marsgx9900/0914/Picture/backward.jpg

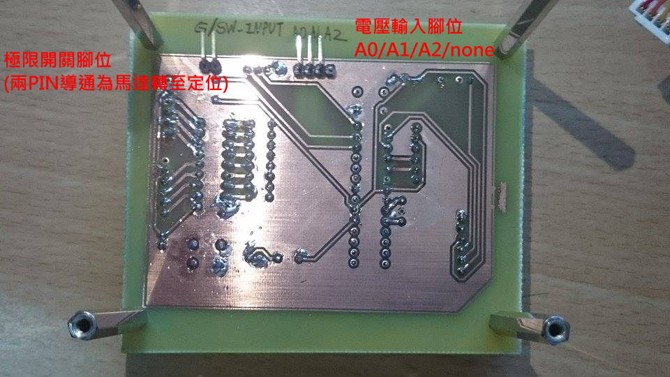
Picture/backward.jpg
