marsgx9900/0914/Picture/forward.jpg

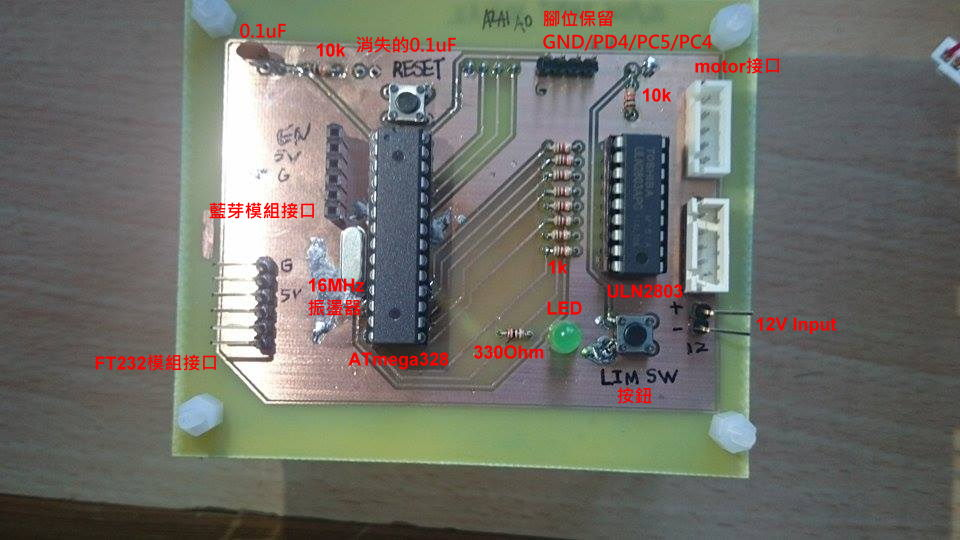
Picture/forward.jpg
