marsgx9900/0914/Layout/5Vto3V3_VoltageConverter/psu_sch.png

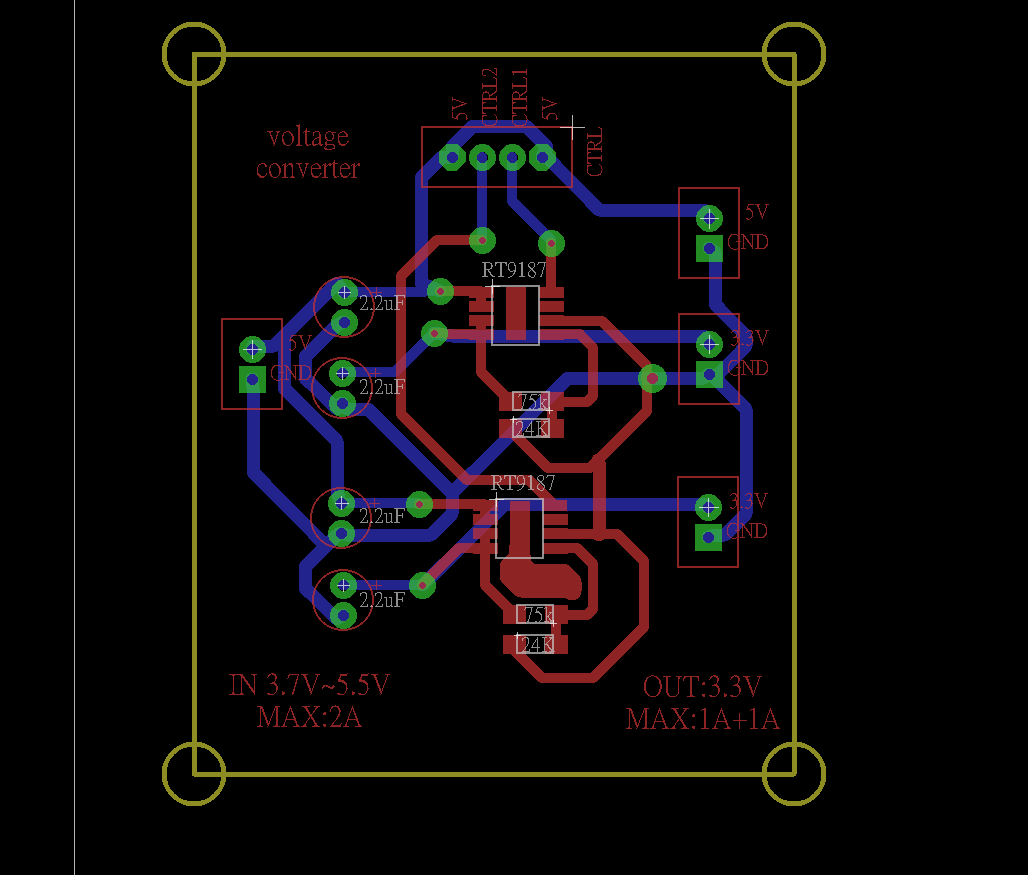
Layout/5Vto3V3_VoltageConverter/psu_sch.png
