marsgx9900/0914/Layout/LNA控制電路/schPic.png

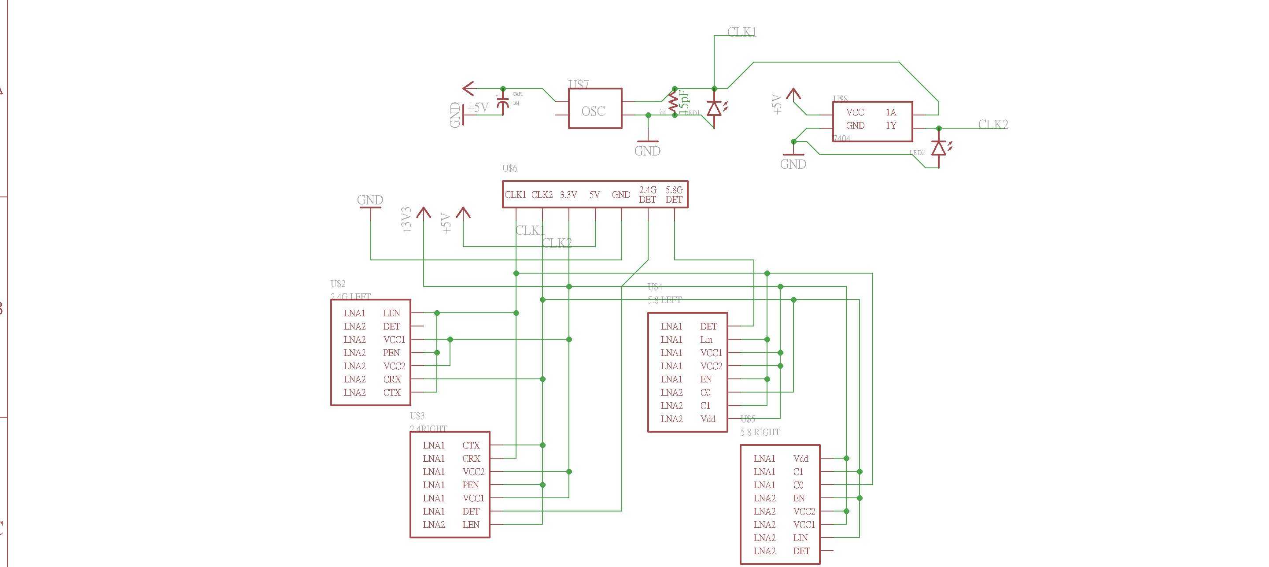
Layout/LNA控制電路/schPic.png
