marsgx9900/0914/Layout/main/brdPic.png

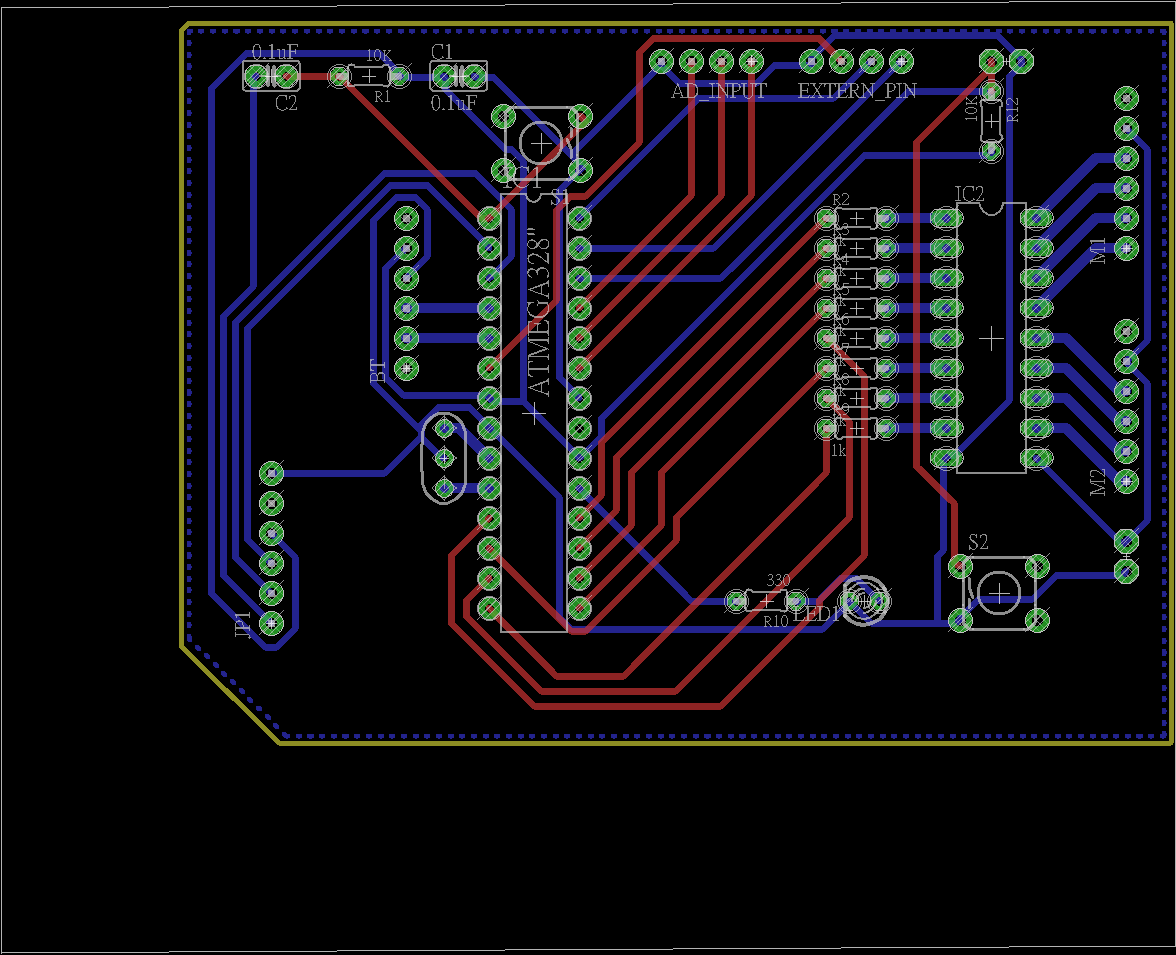
Layout/main/brdPic.png
