marsgx9900/0914/Layout/main/schPic.png

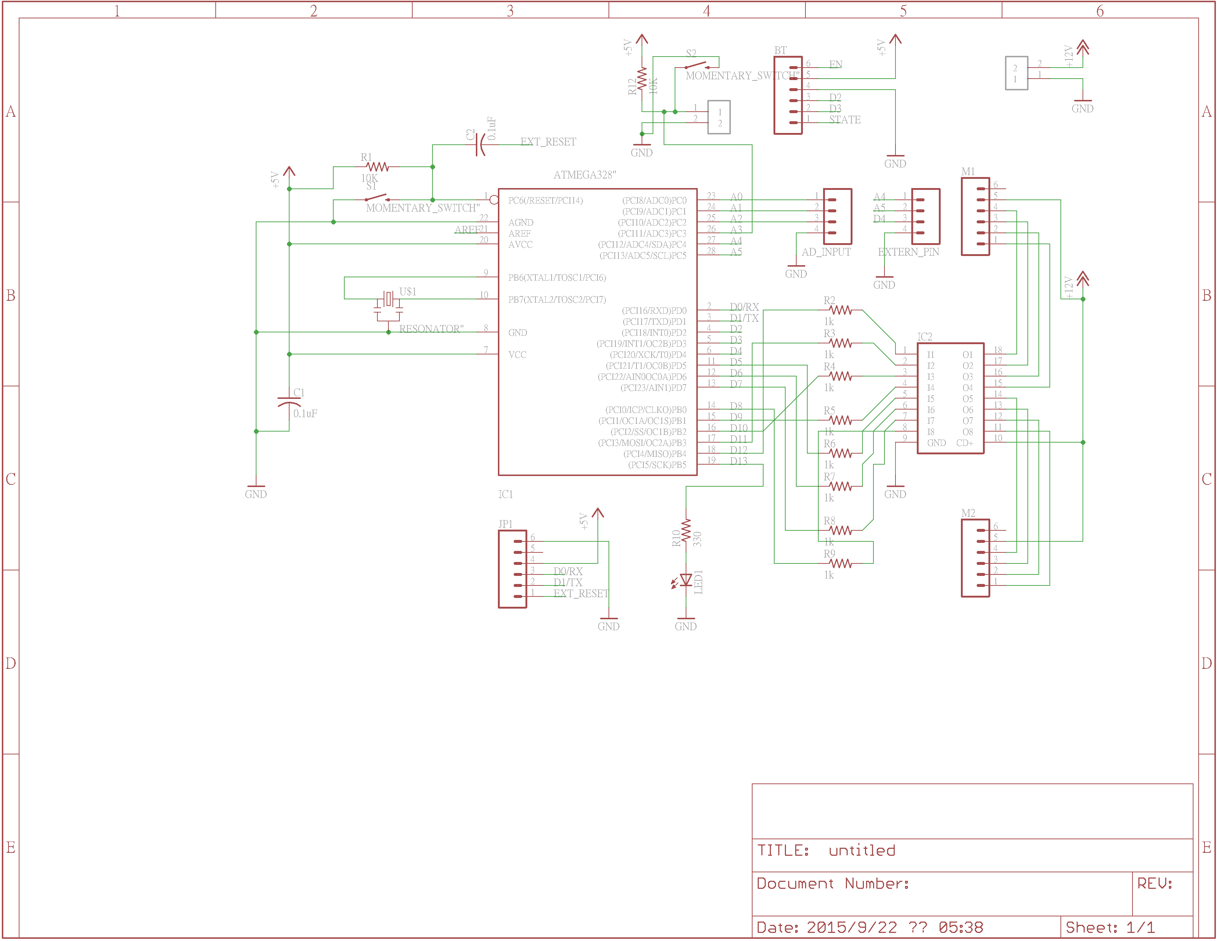
Layout/main/schPic.png
