marsgx9900/0914/Layout/LNA匹配電路/匹配電路.pdf

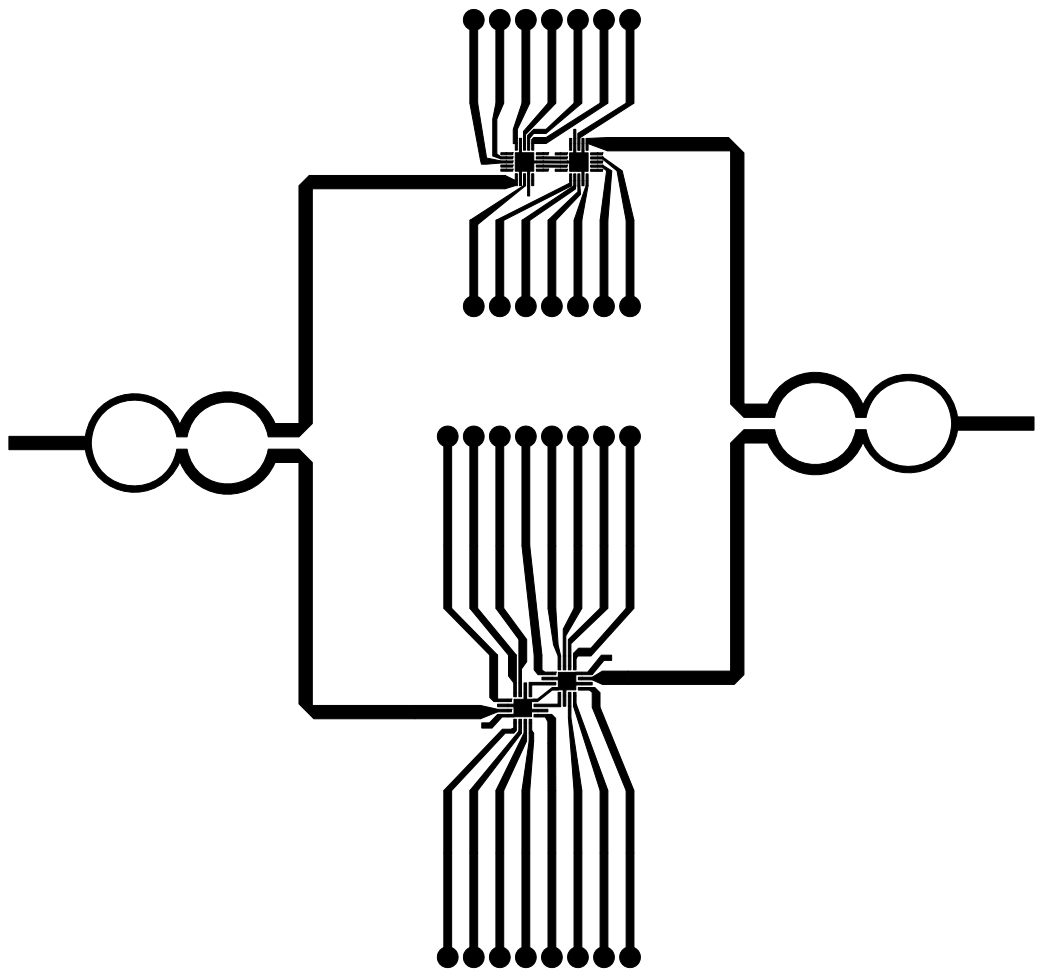
[picture p39: page 1]
