marsgx9900/0914/Layout/LNA控制電路/top.pdf

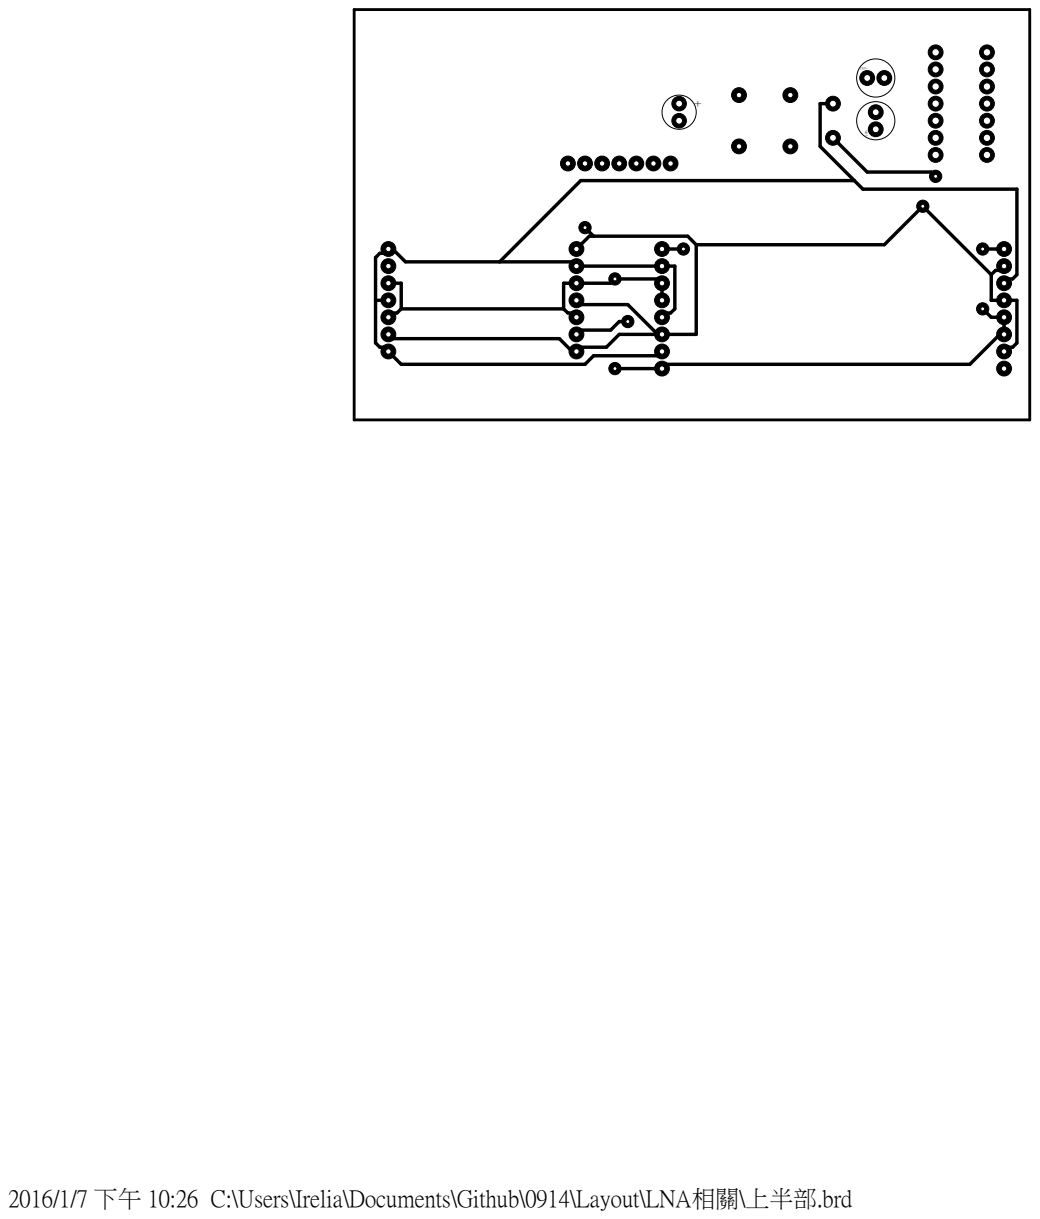
[picture p40: page 1]

2016/1/7 下午 10:26 C:\Users\Irelia\Documents\Github\0914\Layout\LNA相關\上半部.brd
