marsgx9900/0914/Layout/LNA控制電路/控制電路_bot.pdf

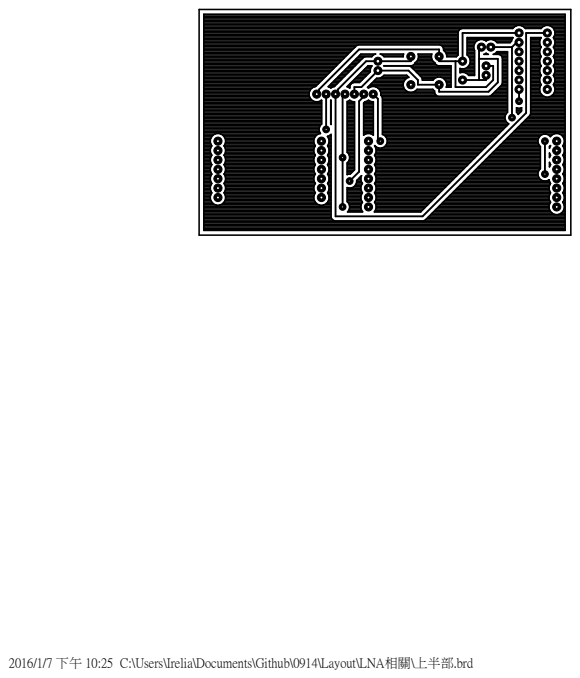
[picture p41: page 1]

2016/1/7 下午 10:25 C:\Users\Irelia\Documents\Github\0914\Layout\LNA相關\上半部.brd
