marsgx9900/0914/Layout/5Vto3V3_VoltageConverter/bottom.pdf

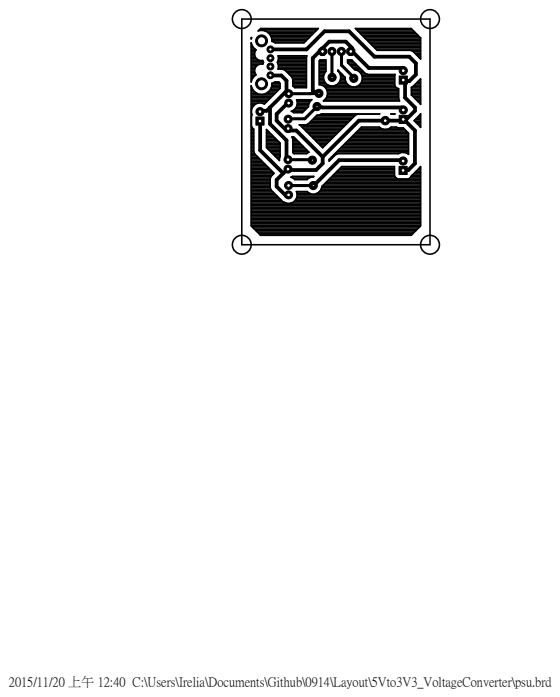
[picture p42: page 1]

2015/11/20 上午 12:40 C:\Users\Irelia\Documents\Github\0914\Layout\5Vto3V3_VoltageConverter\psu.brd
