marsgx9900/0914/Layout/5Vto3V3_VoltageConverter/top.pdf

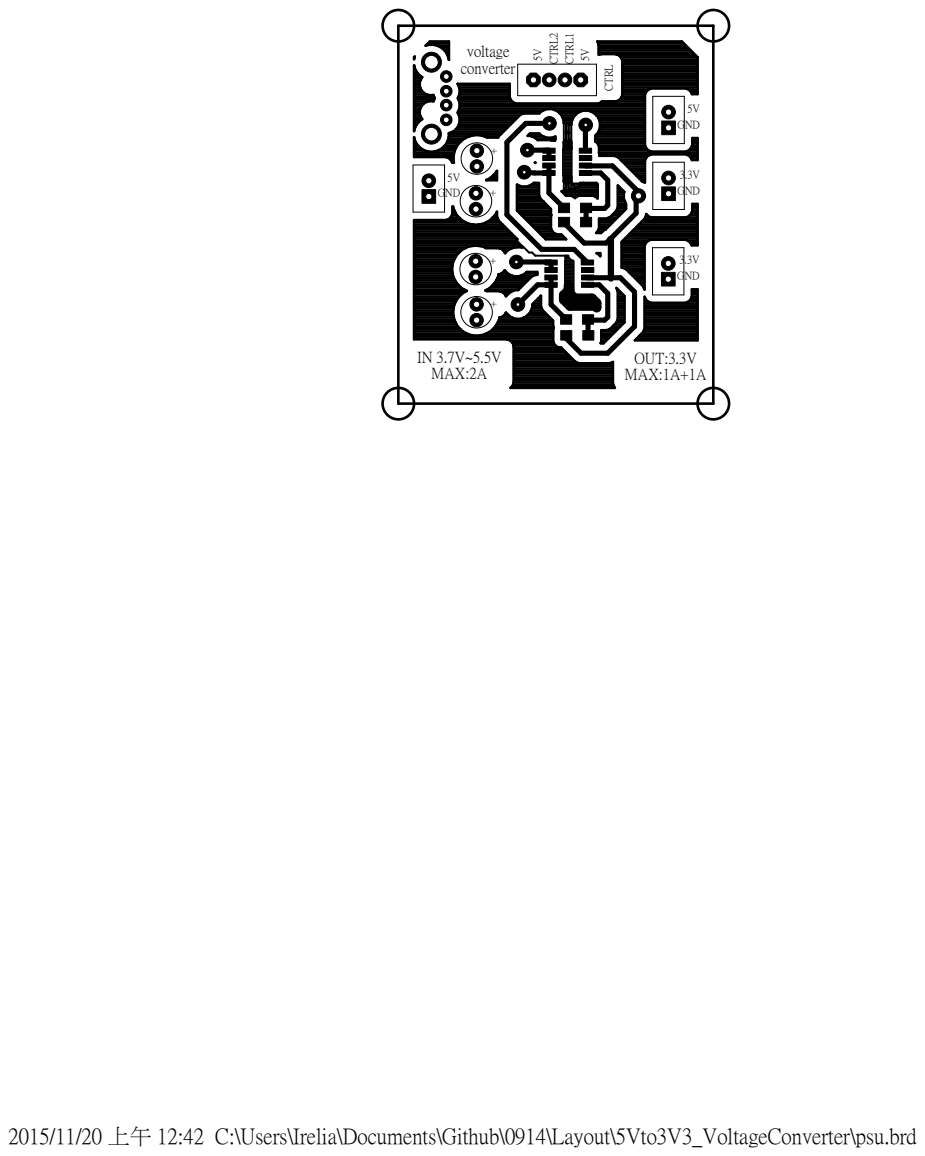
[picture p43: page 1]

2015/11/20 上午 12:42 C:\Users\Irelia\Documents\Github\0914\Layout\5Vto3V3_VoltageConverter\psu.brd
