marsgx9900/0914/Layout/main/bottom.pdf

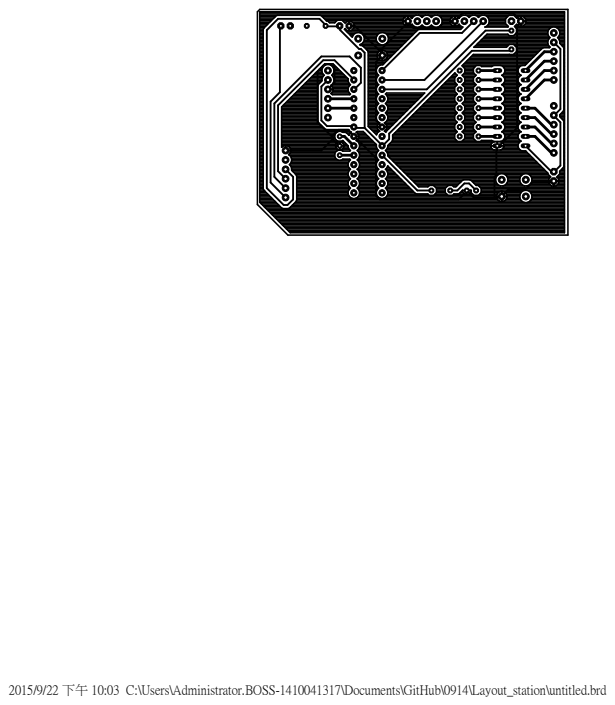
[picture p44: page 1]

2015/9/22 下午 10:03 C:\Users\Administrator.BOSS-1410041317\Documents\GitHub\0914\Layout_station\untitled.brd
