marsgx9900/0914/Layout/main/top.pdf

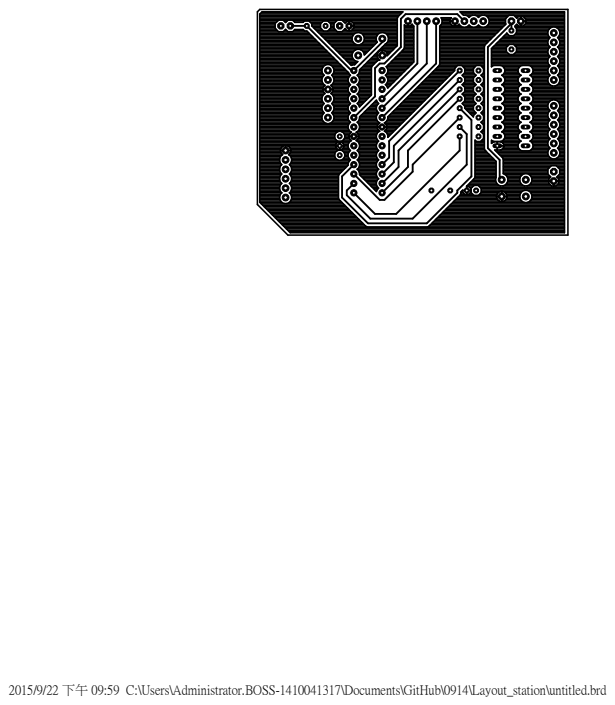
[picture p45: page 1]

2015/9/22 下午 09:59 C:\Users\Administrator.BOSS-1410041317\Documents\GitHub\0914\Layout_station\untitled.brd
