marsgx9900/0914/Layout/LNA控制電路/控制電路.brd

## EAGLE design Layout/LNA控制電路/控制電路.brd (2016-01-09)

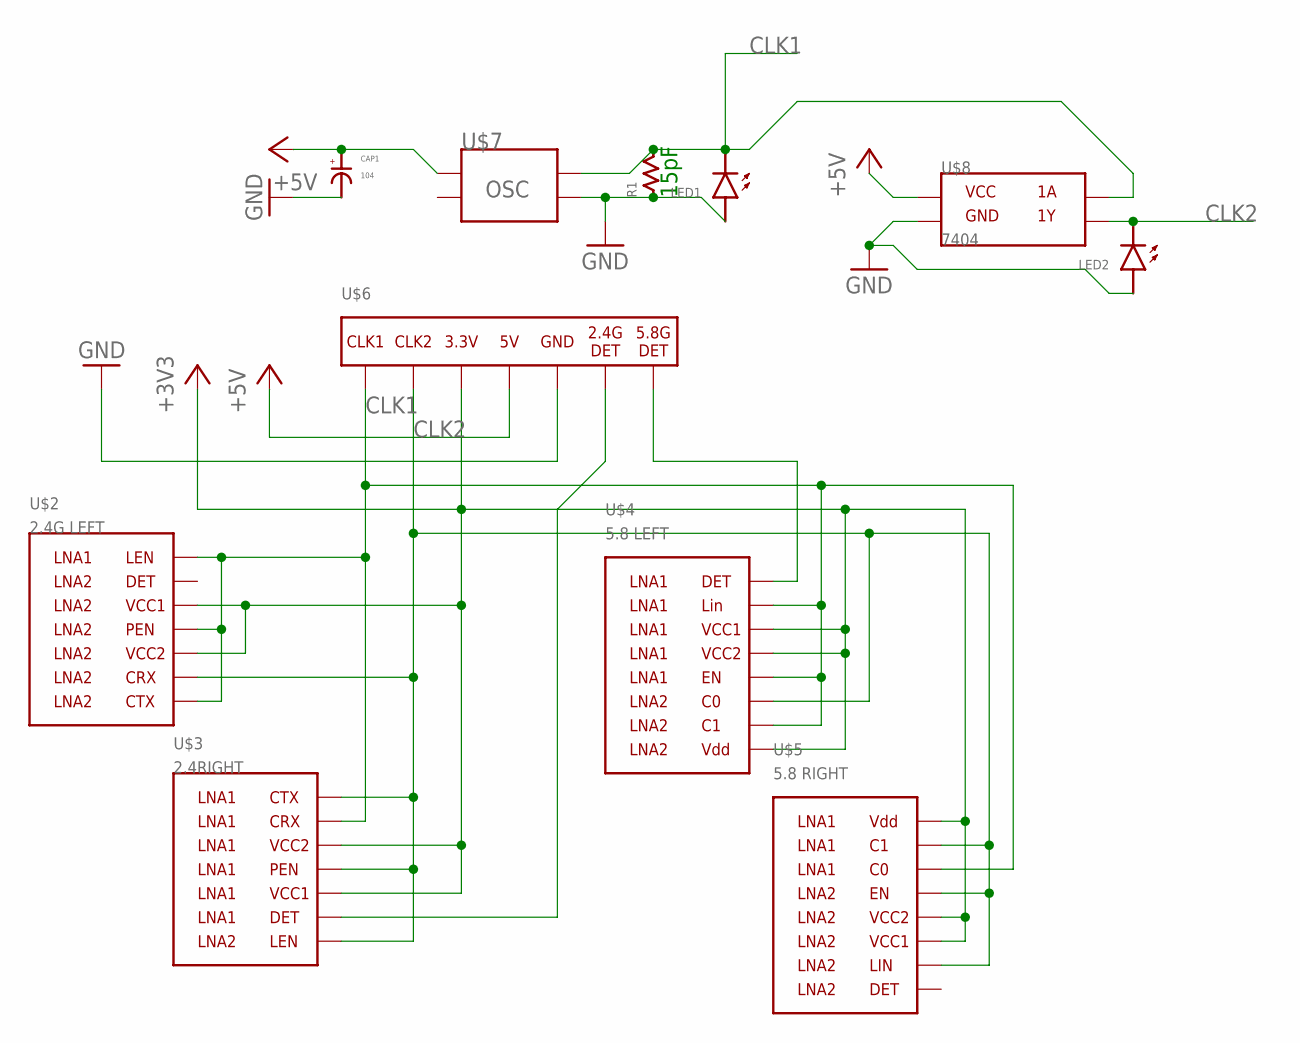
[picture p46: schematic 控制電路.sch]

Parts:
CAP1: 104; CAP-100MIL
LED1, LED2: LED-5MM; 2-PIN-200MIL-LED
R1: RESISTOR-200MIL
U$2: PROJECT-2.4G-LEFTSIDE
U$3: PROJECT-2.4G-RIGHTSIDE
U$4: PROJECT-5G-LEFTSIDE
U$5: PROJECT-5G-RIGHTSIDE
U$6: PROJECT-IO
U$7: PROJECT-CRYSTAL
U$8: PROJECT-7404

Connections:
+3V3: U$2.VCC1, U$2.VCC2, U$3.VCC1, U$3.VCC2, U$4.VCC1, U$4.VCC2, U$4.VDD, U$5.VCC1, U$5.VCC2, U$5.VDD, U$6.3.3V
+5V: CAP1.P$1, U$6.5V, U$7.P$1, U$8.P$14
CLK1: LED1.L- (LED-), R1.P$2, U$2.CTX, U$2.LEN, U$2.PEN, U$3.CRX, U$4.C1, U$4.EN, U$4.LIN, U$5.C0, U$6.CLK1, U$7.P$4, U$8.P$1
CLK2: LED2.L- (LED-), U$2.CRX, U$3.CTX, U$3.LEN, U$3.PEN, U$4.C0, U$5.C1, U$5.EN, U$5.LIN, U$6.CLK2, U$8.P$2
GND: CAP1.P$2, LED1.L+ (LED+), LED2.L+ (LED+), R1.P$1, U$6.GND, U$7.P$3, U$8.P$7
unnamed: U$3.DET, U$6.2.4DET
unnamed: U$4.DET, U$6.5.8DET

Notes on the sheet:
15pF

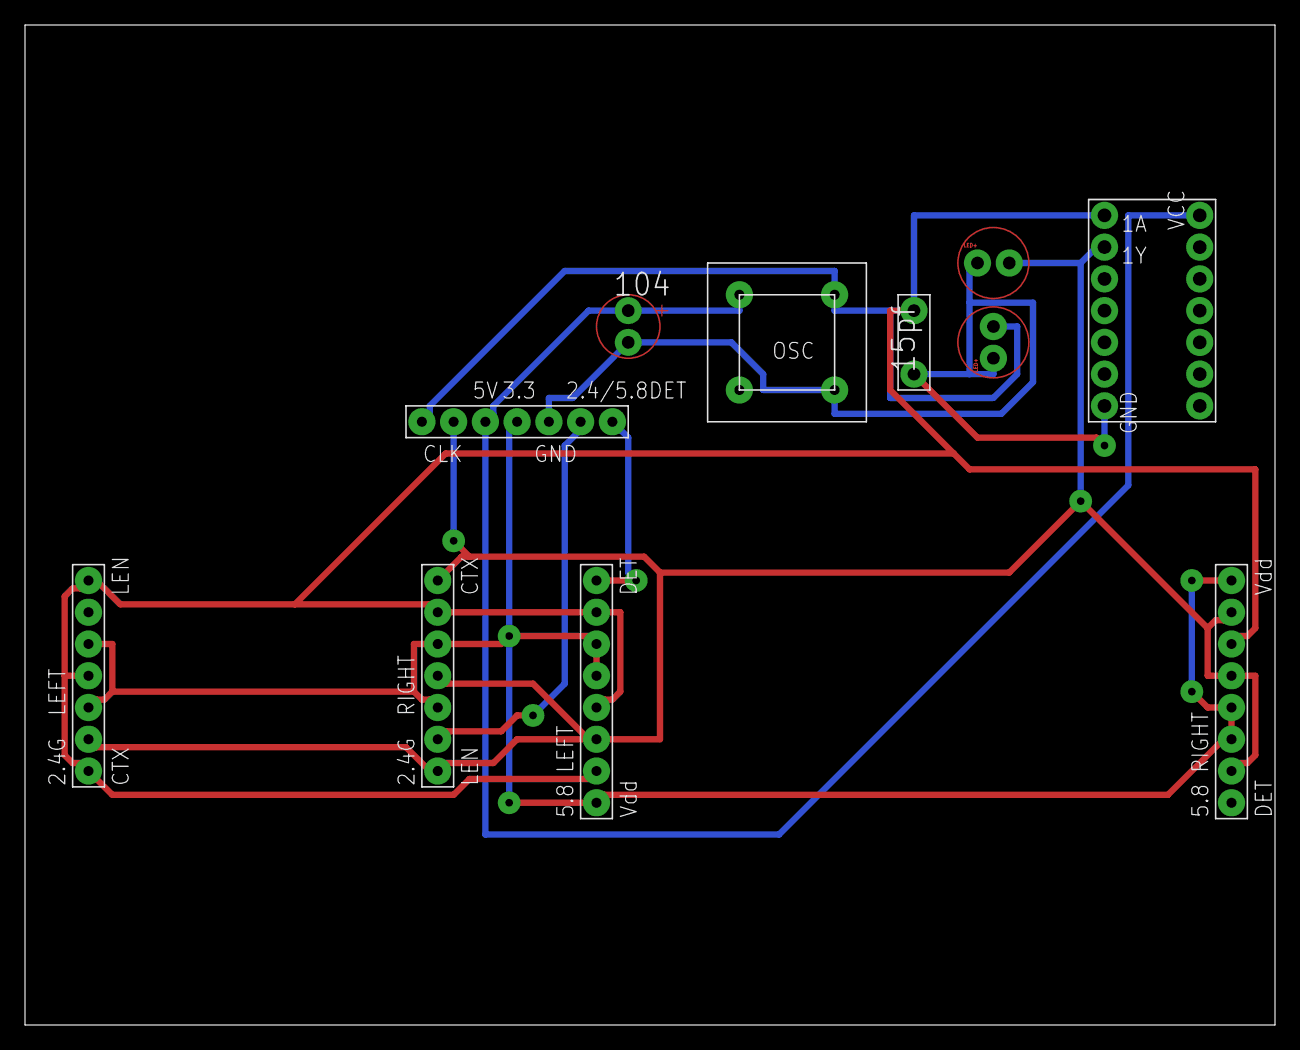
[picture p47: board 控制電路.brd from above]

Board: 2 copper layers, 100.0 x 80.0 mm, 11 parts (0 on the bottom side), 7 nets.
