marsgx9900/0914/Layout/5Vto3V3_VoltageConverter/psu.brd

## EAGLE design Layout/5Vto3V3_VoltageConverter/psu.brd (2015-11-19)

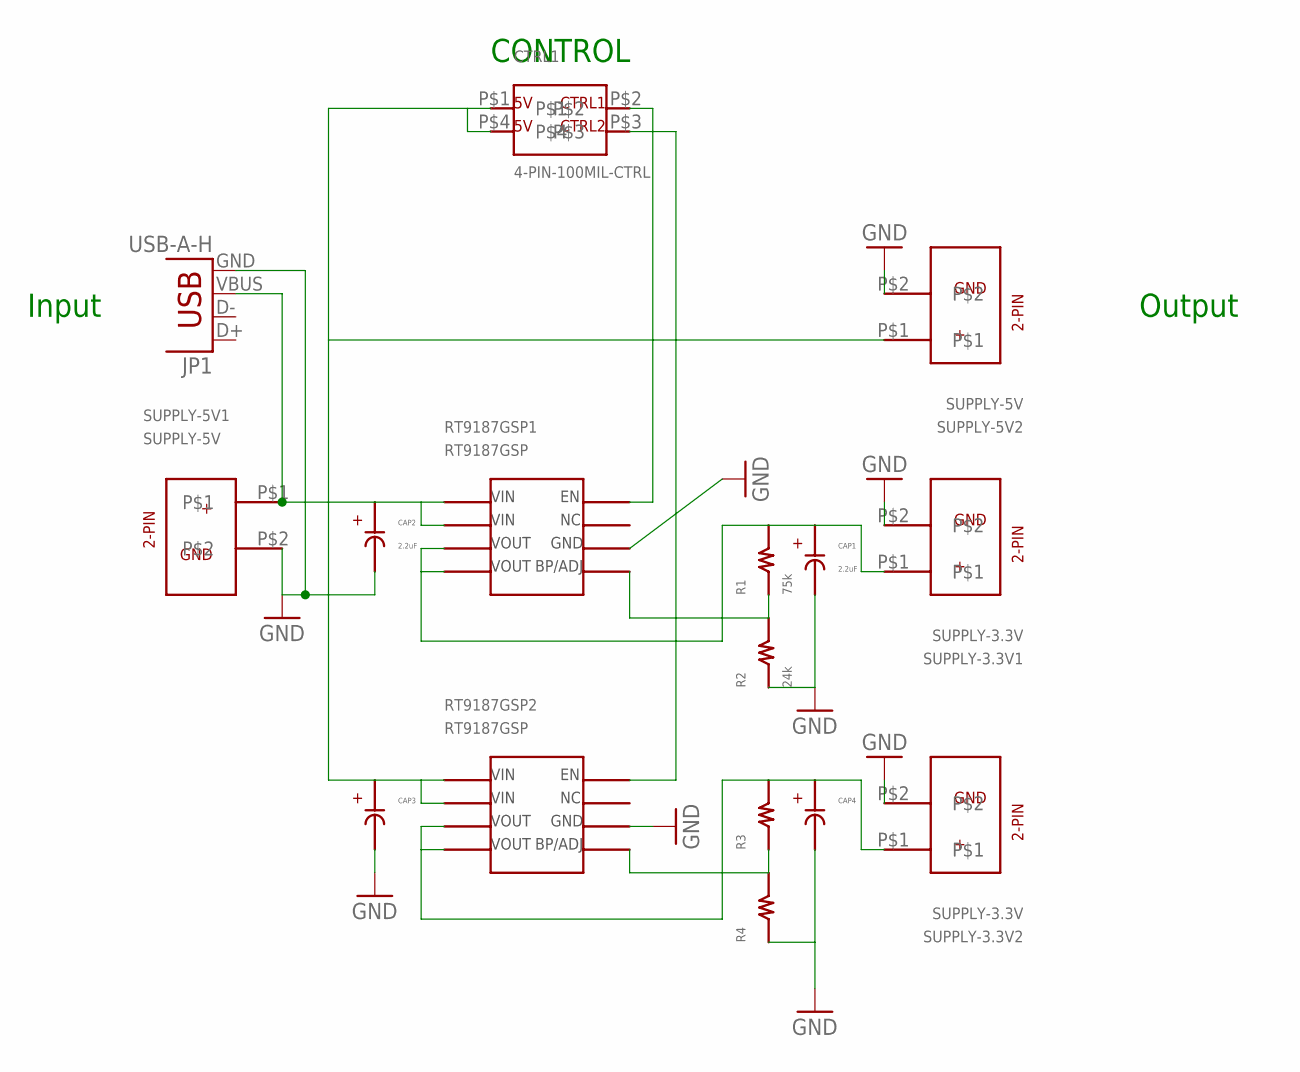
[picture p48: schematic psu.sch]

Parts:
CAP1, CAP2: 2.2uF; CAP-100MIL
CAP3, CAP4: CAP-100MIL
CTRL1: 4-PIN-100MIL-CTRL
JP1: USB-A-H
R1: 75k; RESISTOR-SMD-1206
R2: 24k; RESISTOR-SMD-1206
R3, R4: RESISTOR-SMD-1206
RT9187GSP1, RT9187GSP2: RT9187GSP; SOP-8
SUPPLY-3.3V1, SUPPLY-3.3V2: SUPPLY-3.3V; 2-PIN-100MIL-3.3V
SUPPLY-5V1, SUPPLY-5V2: SUPPLY-5V; 2-PIN-100MIL-5V

Connections:
GND: CAP1.P$2, CAP2.P$2, CAP3.P$2, CAP4.P$2, JP1.GND, R2.P$1, R4.P$1, RT9187GSP1.P$6, RT9187GSP2.P$6, SUPPLY-3.3V1.P$2, SUPPLY-3.3V2.P$2, SUPPLY-5V1.P$2, SUPPLY-5V2.P$2
unnamed: R1.P$1, R2.P$2, RT9187GSP1.P$5
unnamed: CTRL1.P$2, RT9187GSP1.P$8
unnamed: CAP1.P$1, R1.P$2, RT9187GSP1.P$3, RT9187GSP1.P$4, SUPPLY-3.3V1.P$1
unnamed: CAP4.P$1, R3.P$2, RT9187GSP2.P$3, RT9187GSP2.P$4, SUPPLY-3.3V2.P$1
unnamed: R3.P$1, R4.P$2, RT9187GSP2.P$5
unnamed: CTRL1.P$3, RT9187GSP2.P$8
unnamed: CAP2.P$1, CAP3.P$1, CTRL1.P$1, CTRL1.P$4, JP1.VBUS, RT9187GSP1.P$1, RT9187GSP1.P$2, RT9187GSP2.P$1, RT9187GSP2.P$2, SUPPLY-5V1.P$1, SUPPLY-5V2.P$1

Notes on the sheet:
Input
Output
CONTROL

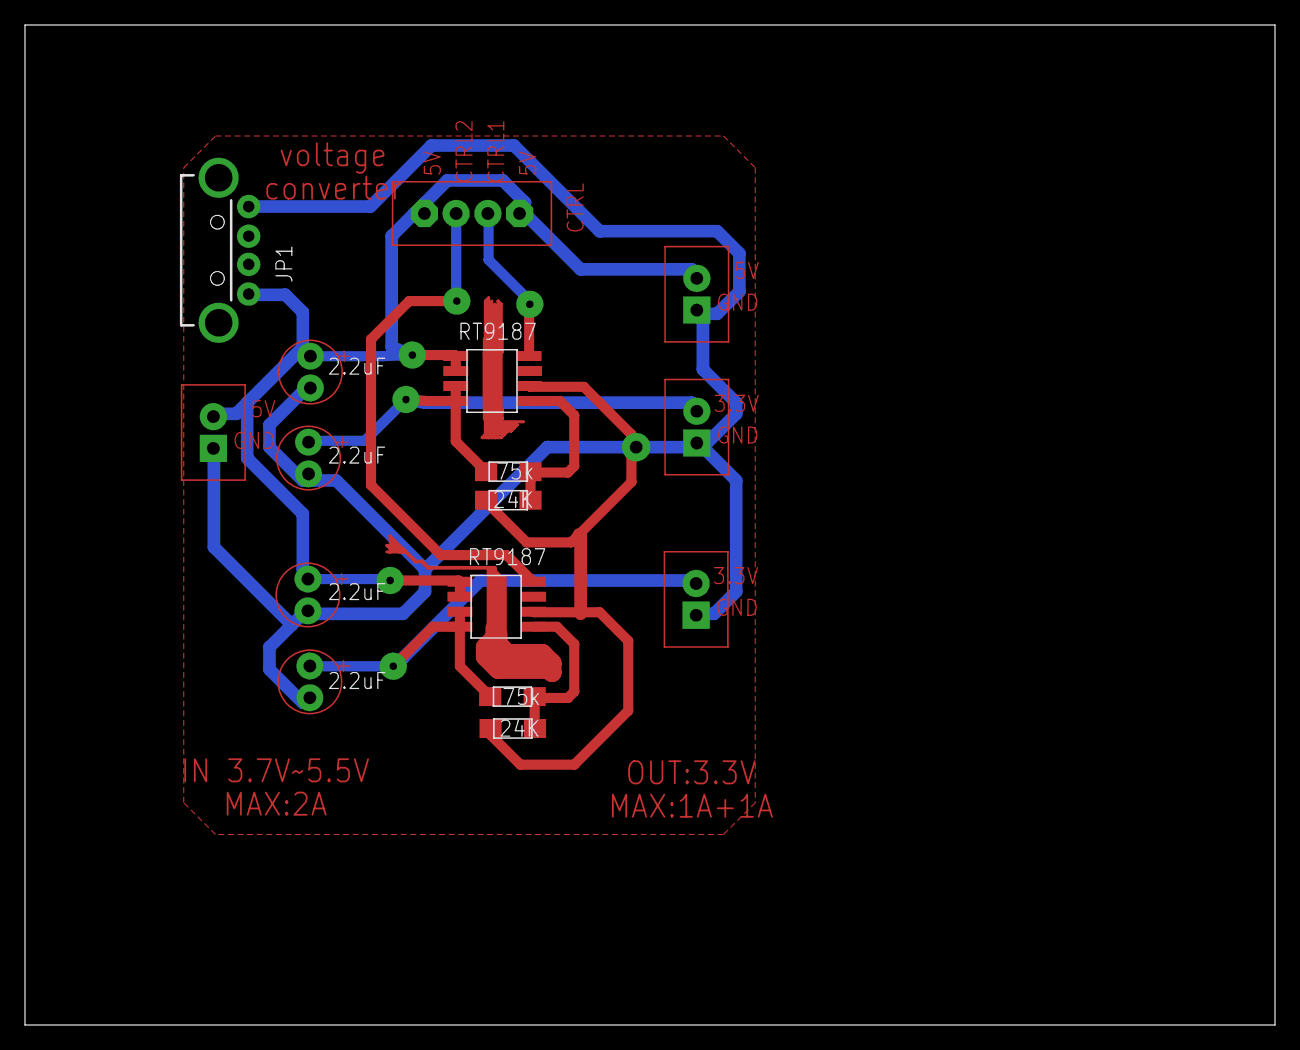
[picture p49: board psu.brd from above]

Board: 2 copper layers, 100.0 x 80.0 mm, 16 parts (0 on the bottom side), 8 nets.
