marsgx9900/0914/Layout/main/untitled.brd

## EAGLE design Layout/main/untitled.brd (2015-09-22)

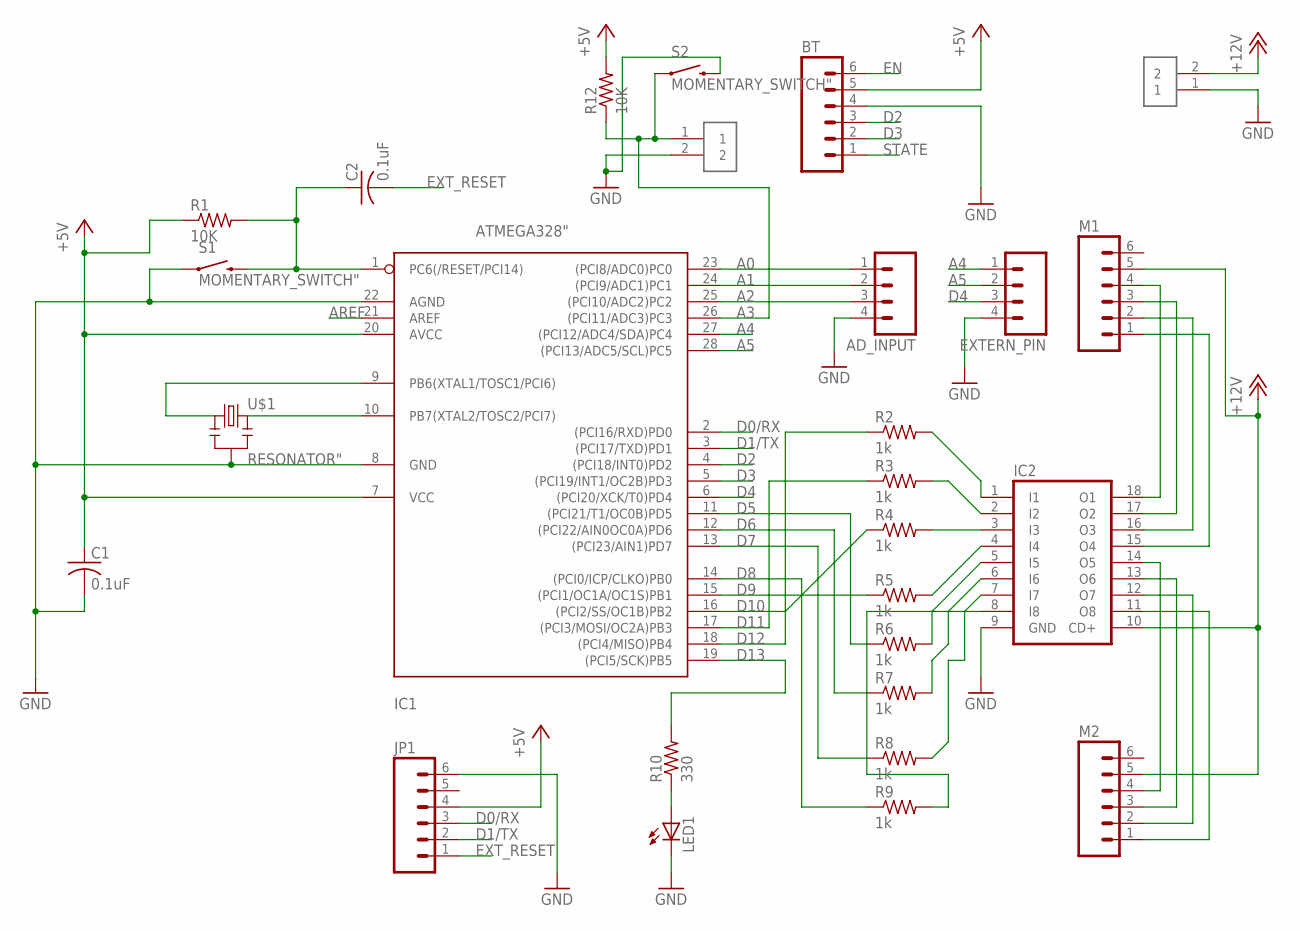
[picture p50: schematic untitled.sch]

Parts:
12V_INPUT: 1X02_HEADER
AD_INPUT: 1X04_HEADER"; 1X04_HEADER
BT: 1X06_HEADER"; 1X06_HEADER
C1, C2: 0.1uF; UNPOLARIZED_CAP
EXTERN_PIN: 1X04_HEADER"; 1X04_HEADER
IC1: ATMEGA328"; ATMEGA328
IC2: ULN2803A; DIL18
JP1: 1X06_HEADER"; 1X06_HEADER
LED1: LED3MM; LED
LIMIT_SW: 1X02_HEADER
M1, M2: 1X06_HEADER"; 1X06_HEADER
R1, R12: 10K; RESISTOR
R2, R3, R4, R5, R6, R7, R8, R9: 1k; RESISTOR
R10: 330; RESISTOR
S1, S2: MOMENTARY_SWITCH"; MOMENTARY_SWITCH
U$1: RESONATOR"; RESONATOR

Connections:
+5V: BT.5, C1.1, IC1.7 (VCC), IC1.20 (AVCC), JP1.4, R1.1, R12.2
+12V: 12V_INPUT.2, IC2.10 (CD+), M1.5, M2.5
A0: AD_INPUT.1, IC1.23 ((PCI8/ADC0)PC0)
A1: AD_INPUT.2, IC1.24 ((PCI9/ADC1)PC1)
A2: AD_INPUT.3, IC1.25 ((PCI10/ADC2)PC2)
A3: IC1.26 ((PCI11/ADC3)PC3), LIMIT_SW.1, R12.1, S2.1
A4: EXTERN_PIN.1, IC1.27 ((PCI12/ADC4/SDA)PC4)
A5: EXTERN_PIN.2, IC1.28 ((PCI13/ADC5/SCL)PC5)
AREF: IC1.21 (AREF)
D0/RX: IC1.2 ((PCI16/RXD)PD0), JP1.3
D1/TX: IC1.3 ((PCI17/TXD)PD1), JP1.2
D2: BT.3, IC1.4 ((PCI18/INT0)PD2)
D3: BT.2, IC1.5 ((PCI19/INT1/OC2B)PD3)
D4: EXTERN_PIN.3, IC1.6 ((PCI20/XCK/T0)PD4)
D5: IC1.11 ((PCI21/T1/OC0B)PD5), R6.1
D6: IC1.12 ((PCI22/AIN0OC0A)PD6), R7.1
D7: IC1.13 ((PCI23/AIN1)PD7), R8.1
D8: IC1.14 ((PCI0/ICP/CLKO)PB0), R9.1
D9: IC1.15 ((PCI1/OC1A/OC1S)PB1), R5.1
D10: IC1.16 ((PCI2/SS/OC1B)PB2), R4.1
D11: IC1.17 ((PCI3/MOSI/OC2A)PB3), R3.1
D12: IC1.18 ((PCI4/MISO)PB4), R2.1
D13: IC1.19 ((PCI5/SCK)PB5), R10.2
EN: BT.6
EXT_RESET: C2.2, JP1.1
GND: 12V_INPUT.1, AD_INPUT.4, BT.4, C1.2, EXTERN_PIN.4, IC1.8 (GND), IC1.22 (AGND), IC2.9 (GND), JP1.6, LED1.K (C), LIMIT_SW.2, S1.1, S2.3 (2), U$1.2
unnamed: IC1.9 (PB6(XTAL1/TOSC1/PCI6)), U$1.1
unnamed: IC1.10 (PB7(XTAL2/TOSC2/PCI7)), U$1.3
unnamed: C2.1, IC1.1 (PC6(/RESET/PCI14)), R1.2, S1.3 (2)
unnamed: IC2.1 (I1), R2.2
unnamed: IC2.2 (I2), R3.2
unnamed: IC2.3 (I3), R4.2
unnamed: IC2.4 (I4), R5.2
unnamed: IC2.5 (I5), R6.2
unnamed: IC2.6 (I6), R7.2
unnamed: IC2.7 (I7), R8.2
unnamed: IC2.8 (I8), R9.2
unnamed: IC2.18 (O1), M1.4
unnamed: IC2.17 (O2), M1.3
unnamed: IC2.16 (O3), M1.2
unnamed: IC2.15 (O4), M1.1
unnamed: IC2.14 (O5), M2.4
unnamed: IC2.13 (O6), M2.3
unnamed: IC2.12 (O7), M2.2
unnamed: IC2.11 (O8), M2.1
unnamed: LED1.A, R10.1
STATE: BT.1

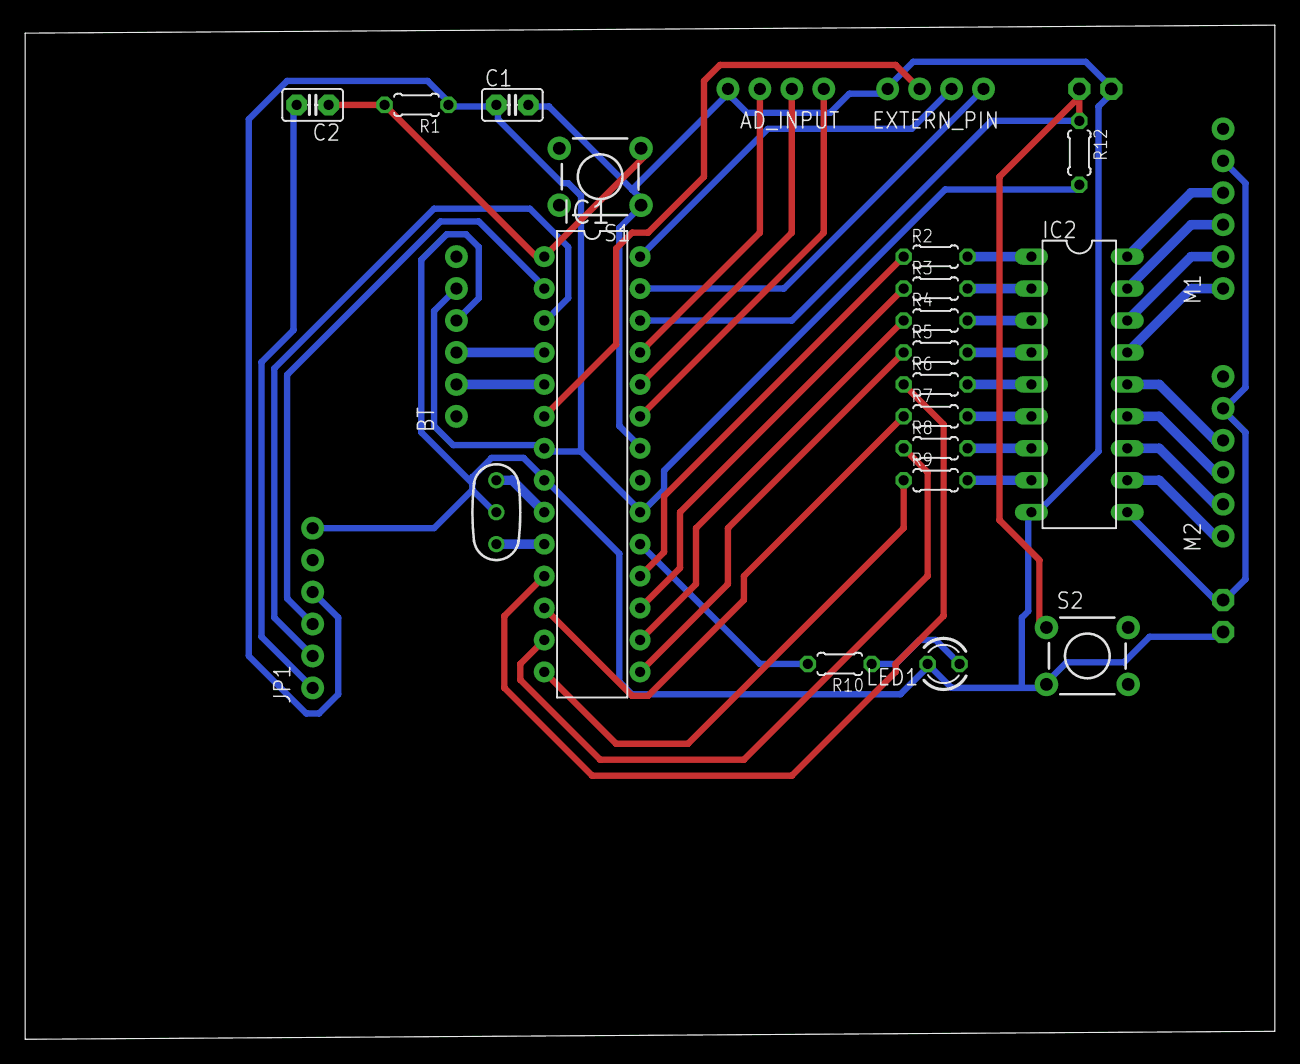
[picture p51: board untitled.brd from above]

Board: 2 copper layers, 99.4 x 80.6 mm, 27 parts (0 on the bottom side), 44 nets.
