marsgx9900/0914/layout/control.brd

## EAGLE design layout/control.brd (2015-09-18)

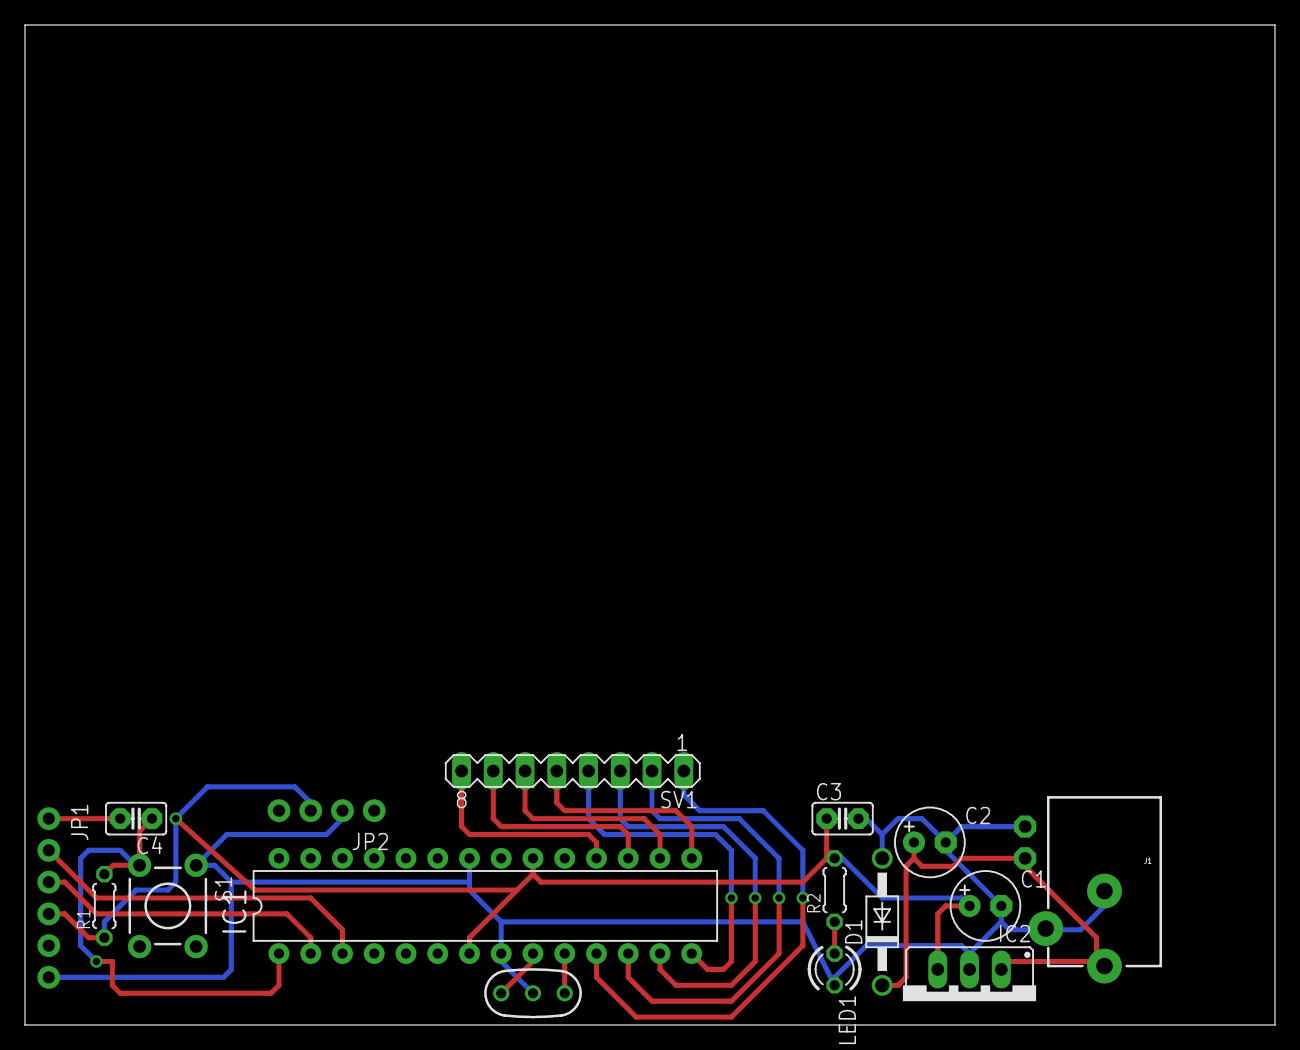
[picture p52: board control.brd from above]

Board: 2 copper layers, 100.0 x 80.0 mm, 17 parts (0 on the bottom side), 19 nets.

Parts:
C1, C2: 47uF; ELECTROLYTIC_CAP
C3, C4: 0.1uF; UNPOLARIZED_CAP
D1: 1N4004; DO41-10
IC1: ATMEGA328"; ATMEGA328
IC2: L4931_REGULATOR
J1: POWER_JACK"; POWER_JACK
JP1: 1X06_HEADER
JP2: 1X04_HEADER
LED1: LED
R1: 10k; RESISTOR
R2: 1k; RESISTOR
S1: MOMENTARY_SWITCH"; MOMENTARY_SWITCH
SV1: MA08-1
U1: RESONATOR"; RESONATOR
U$1: 1X02_HEADER

Connections:
+5V: C1.+, C3.1, IC1.7, IC1.20, IC2.OUT, JP1.4, JP2.3, R1.1, R2.2
D0/RX: IC1.2, JP1.3
D1/TX: IC1.3, JP1.2
D2: IC1.4, JP2.4
D5: IC1.11, SV1.1
D6: IC1.12, SV1.2
D7: IC1.13, SV1.3
D8: IC1.14, SV1.4
D9: IC1.15, SV1.5
D10: IC1.16, SV1.6
D11: IC1.17, SV1.7
D12: IC1.18, SV1.8
EXT_RESET: C4.2, JP1.1
GND: C1.-, C2.-, C3.2, D1.A, IC1.8, IC1.22, IC2.GND, JP1.6, JP2.2, LED1.K, S1.1, U1.2, U$1.2
unnamed: IC1.9, U1.1
unnamed: IC1.10, U1.3
unnamed: LED1.A, R2.1
unnamed: C4.1, IC1.1, R1.2, S1.3
unnamed: C2.+, D1.C, IC2.IN, J1.PWR, U$1.1
