marsgx9900/0914/(commit log)

2015-09-14 fix bug "no such files or directory"
    [0914A.ino]
2015-09-16 control: 尚未定義ATmega328鍵盤腳位 station: LEFT&RIGHT尚未實作其功能 func1功能不齊全
2015-09-17 add layout
    [untitled.sch]
2015-09-18 Finish controler layout!
    [newcontrol.sch, prototype.brd, prototype.sch]
2015-09-18 controler tested on ATmega328 succeed.
    [control.sch, newcontrol.sch]
2015-09-19 加入說明書
2015-09-19 更多的說明
2015-09-19 加入藍芽，更多的註解 remove SoftReset
2015-09-20 remove RF Function 腳位定義完成
2015-09-20 刪除RF剩餘檔案 加入藍芽控制APP
    [prototype.brd, prototype.sch]
2015-09-20 Copy branch 'addBTinStation' files here
    [prototype.brd, prototype.sch]
2015-09-22 "Station" layout completed! Readme updated!
    [untitled.brd, untitled.sch]
2015-09-26 1.Add LED Blink 2.雙層板電路測試:正常運作 3.Add pictures.
2015-09-28 加入圖片註解
2015-10-13 作品說明書完成
2015-11-15 1.資料夾整理，連同Readme.md圖片路徑改寫 2.加入5Vto3V3變壓器佈線圖
    [psu.brd, psu.sch, untitled.brd, untitled.sch]
2015-11-15 註解加入eagle使用到的元件庫連結
2015-11-15 修正註解
2015-11-19 添加3v3電壓轉換器usb接頭
    [psu.brd, psu.sch]
2016-01-09 1.2016/1/9成品上電測試失敗 2.新增LNA相關電路檔案
    [控制電路.brd, 控制電路.sch]
2016-01-09 修改註解
2016-01-17 新增藍芽模組工具包
